abotvinik/Pololu-Lane-Keeping/TestImages/test_mergeR.jpg

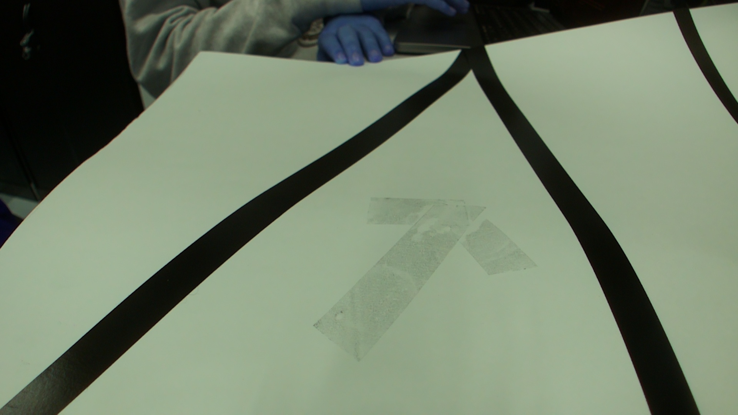
TestImages/test_mergeR.jpg
