abotvinik/Pololu-Lane-Keeping/TestImages/test_right.jpg

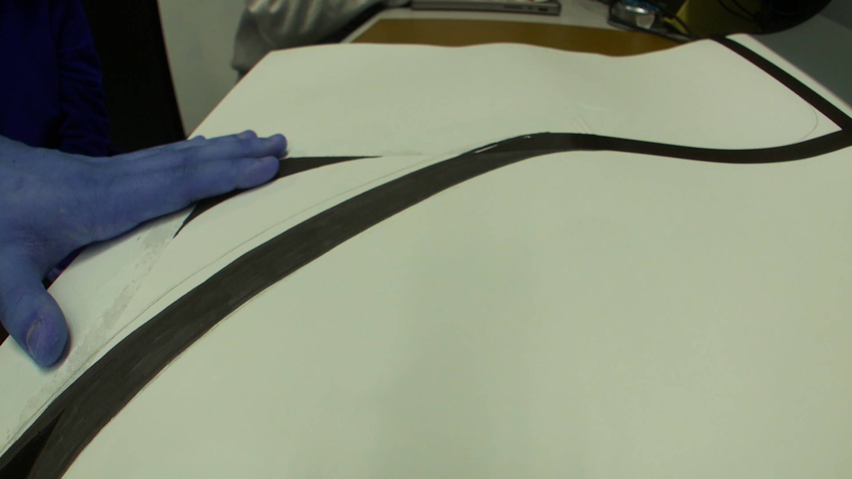
TestImages/test_right.jpg
