abotvinik/Pololu-Lane-Keeping/demo tracks.pdf

Driving Straight

Turns

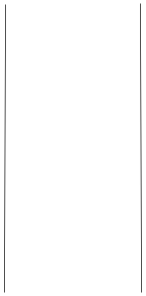
[picture p4: figure]
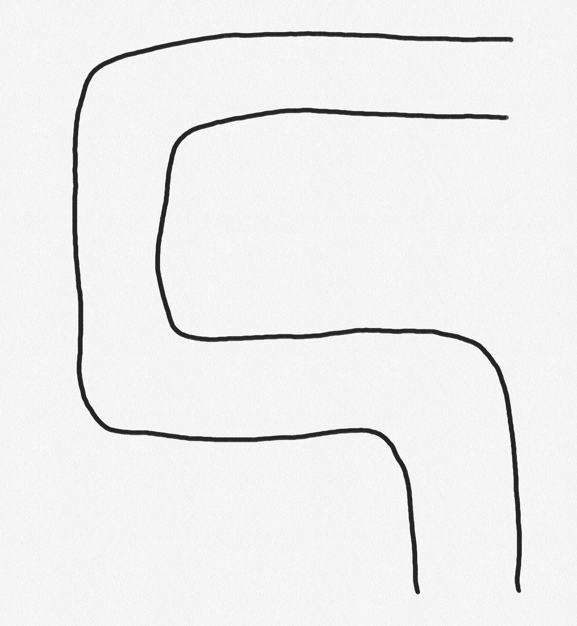
[picture p5: figure]

Merge Lanes

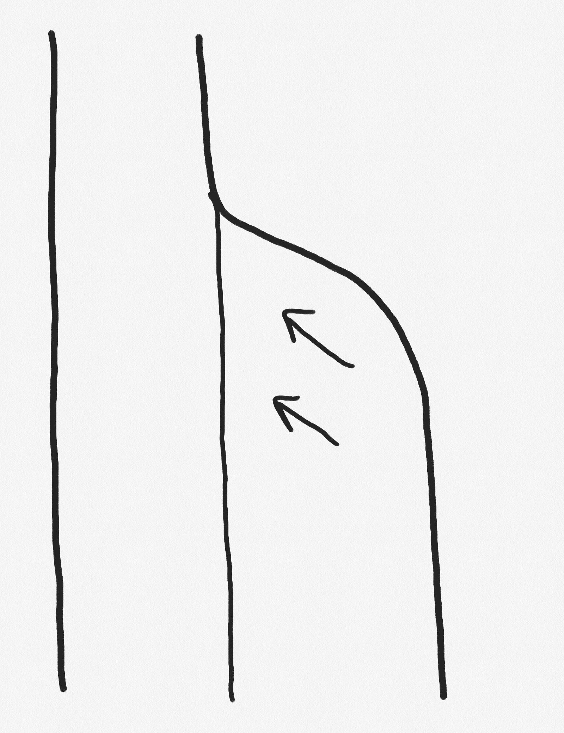
[picture p6: figure]

Final demo

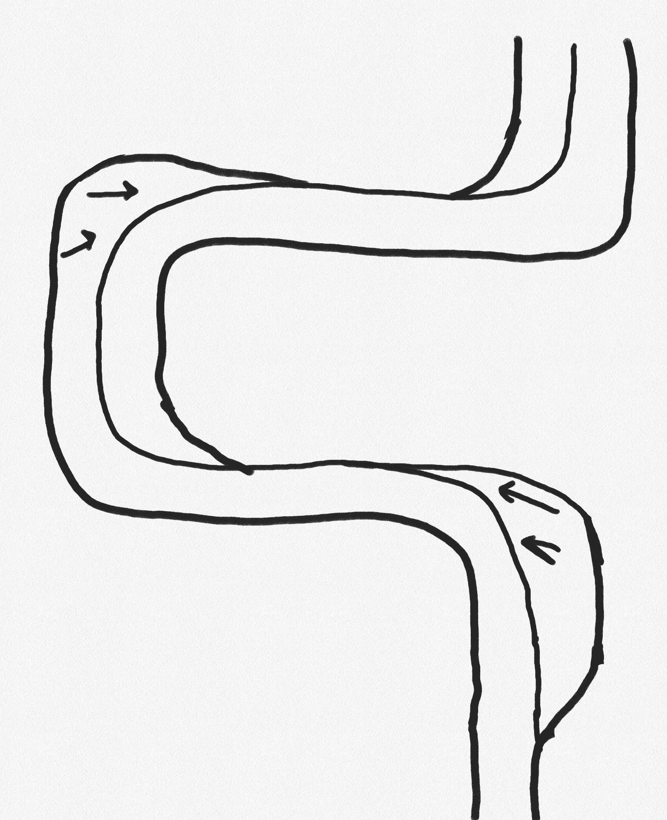
[picture p7: figure]
