abotvinik/Pololu-Lane-Keeping/CAD Models/RBPB.stl

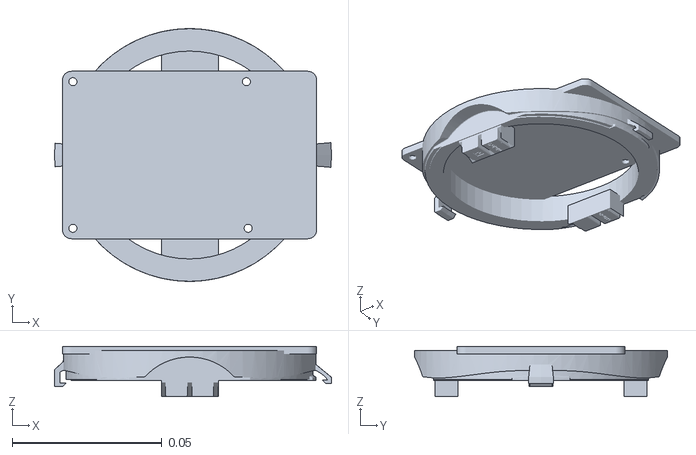
[picture p8: CAD file, 2023-11-08]
CAD Models/RBPB.stl
0.0926 x 0.0845 x 0.0167
