abotvinik/Pololu-Lane-Keeping/CADModels/RSPWITHBTTRYHLDER.stl

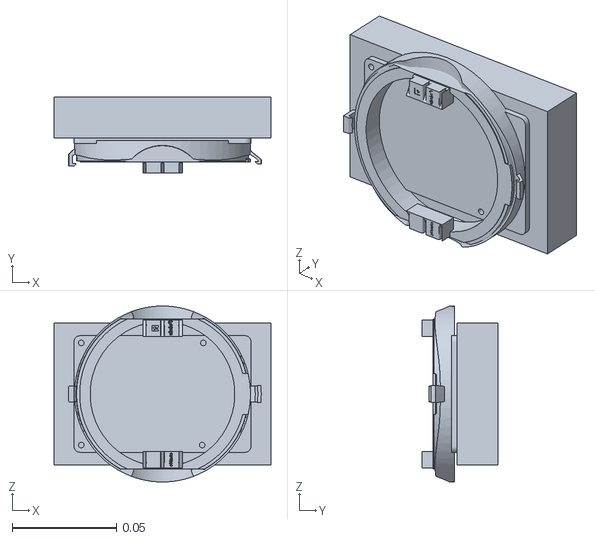
[picture p9: CAD file, 2023-12-04]
CADModels/RSPWITHBTTRYHLDER.stl
0.104 x 0.0364 x 0.0845
