abotvinik/Pololu-Lane-Keeping/TestImages/edges_left.jpg

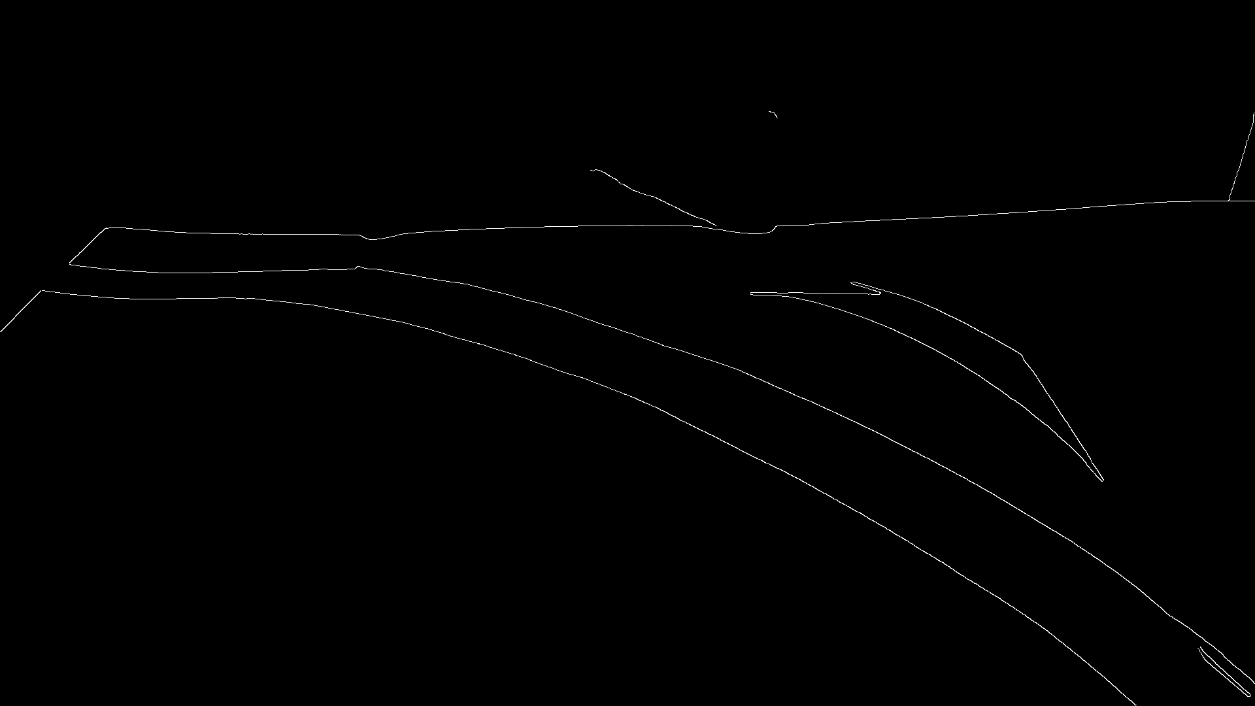
TestImages/edges_left.jpg
