abotvinik/Pololu-Lane-Keeping/TestImages/edges_mergeL.jpg

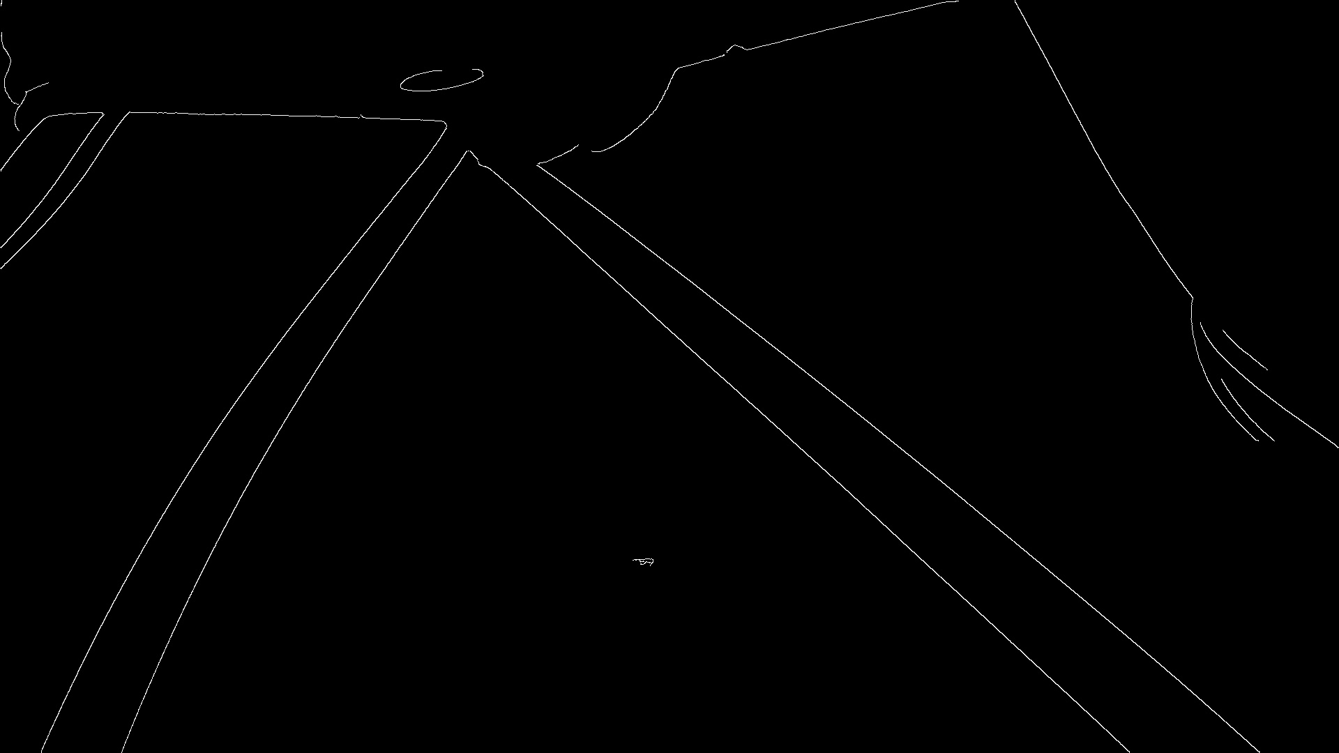
TestImages/edges_mergeL.jpg
