abotvinik/Pololu-Lane-Keeping/TestImages/edges_mergeR.jpg

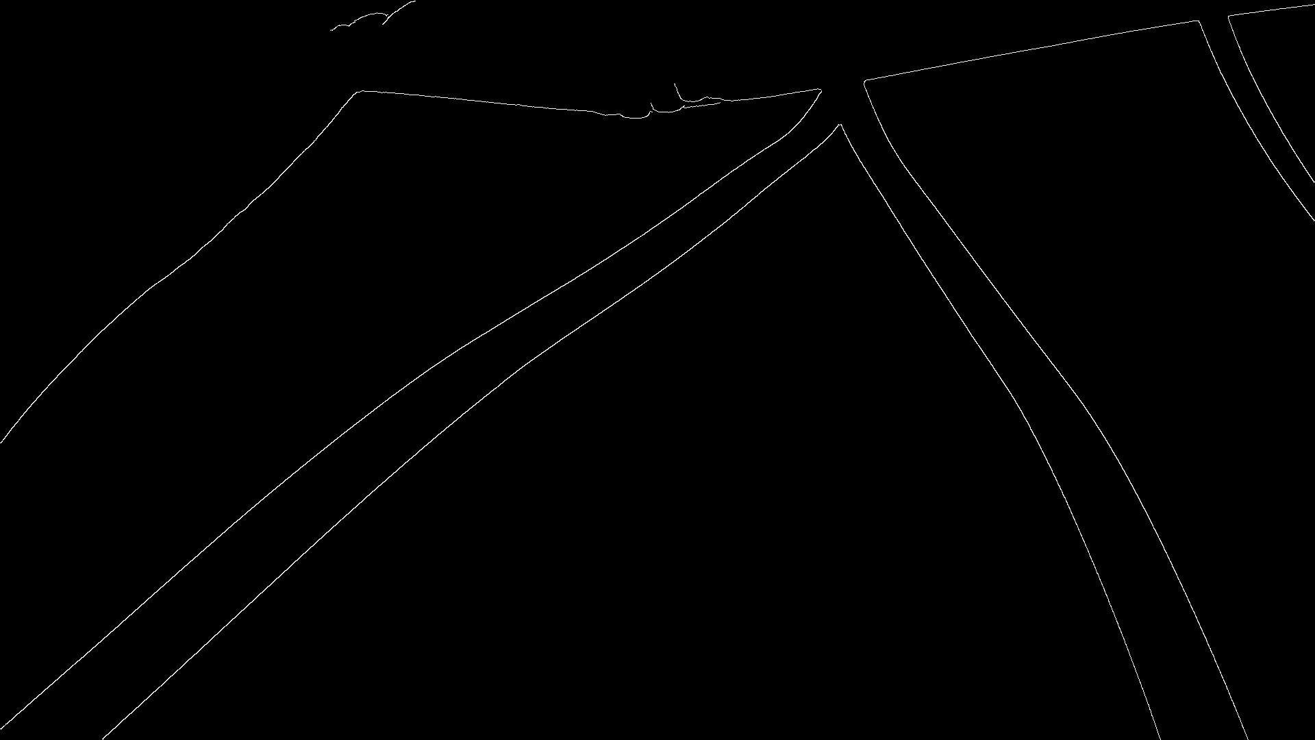
TestImages/edges_mergeR.jpg
