abotvinik/Pololu-Lane-Keeping/TestImages/edges_right.jpg

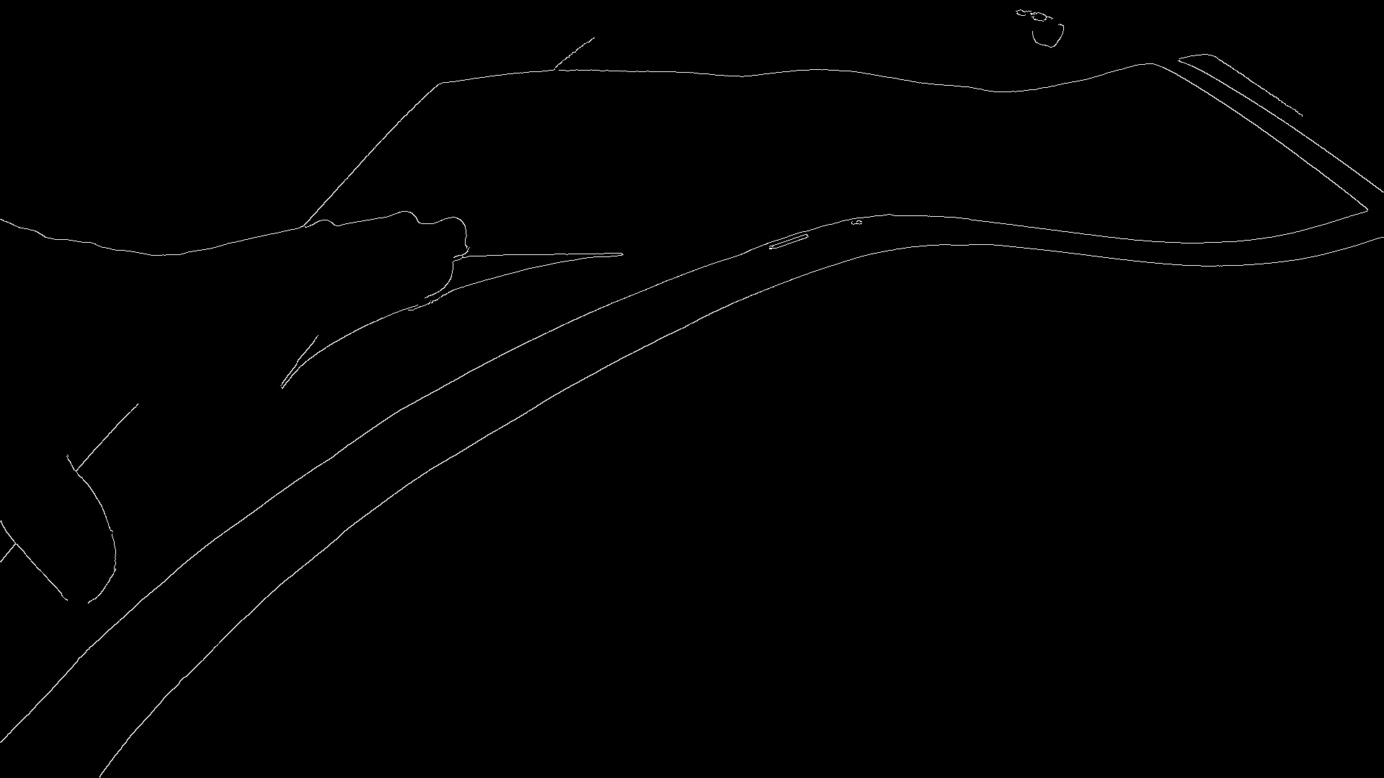
TestImages/edges_right.jpg
