abotvinik/Pololu-Lane-Keeping/TestImages/edges_straight.jpg

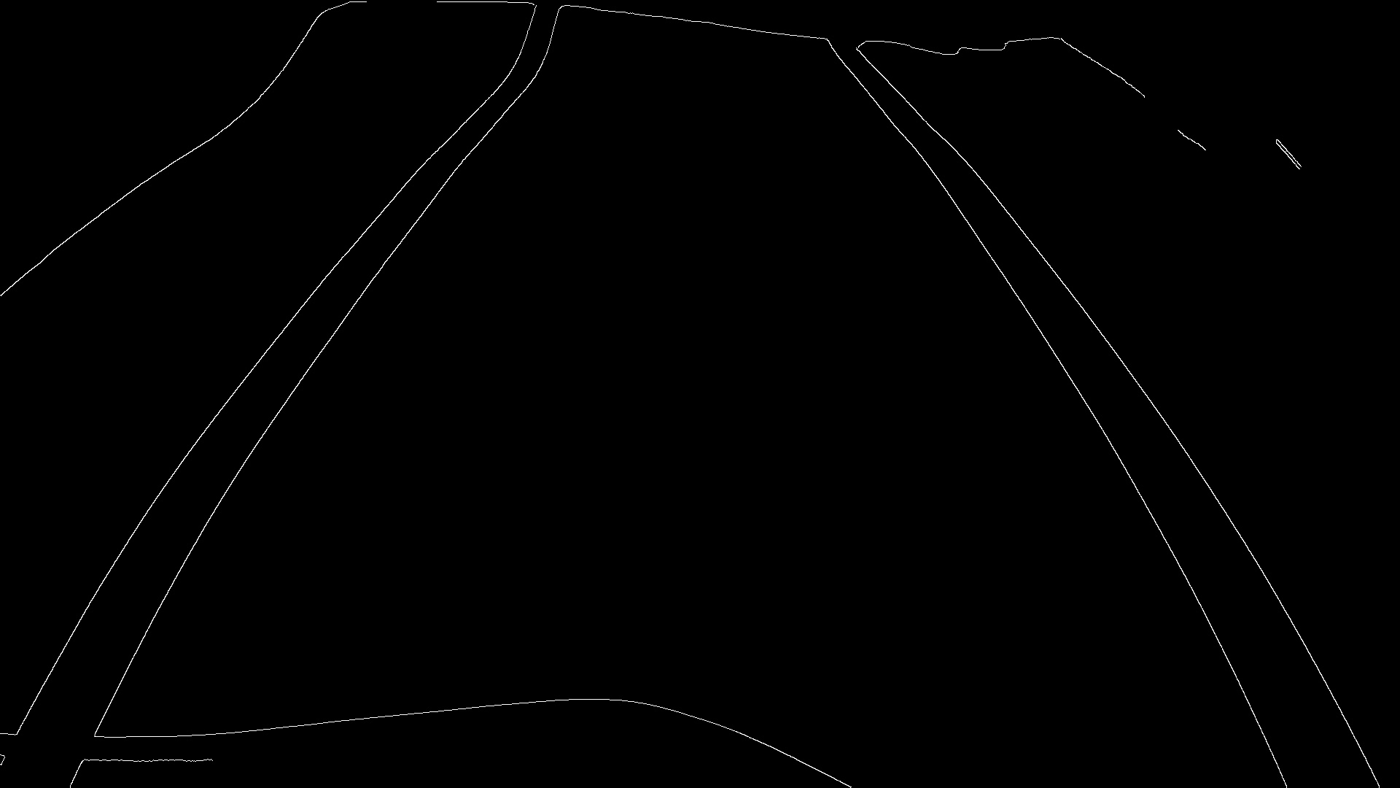
TestImages/edges_straight.jpg
