abotvinik/Pololu-Lane-Keeping/TestImages/test_left.jpg

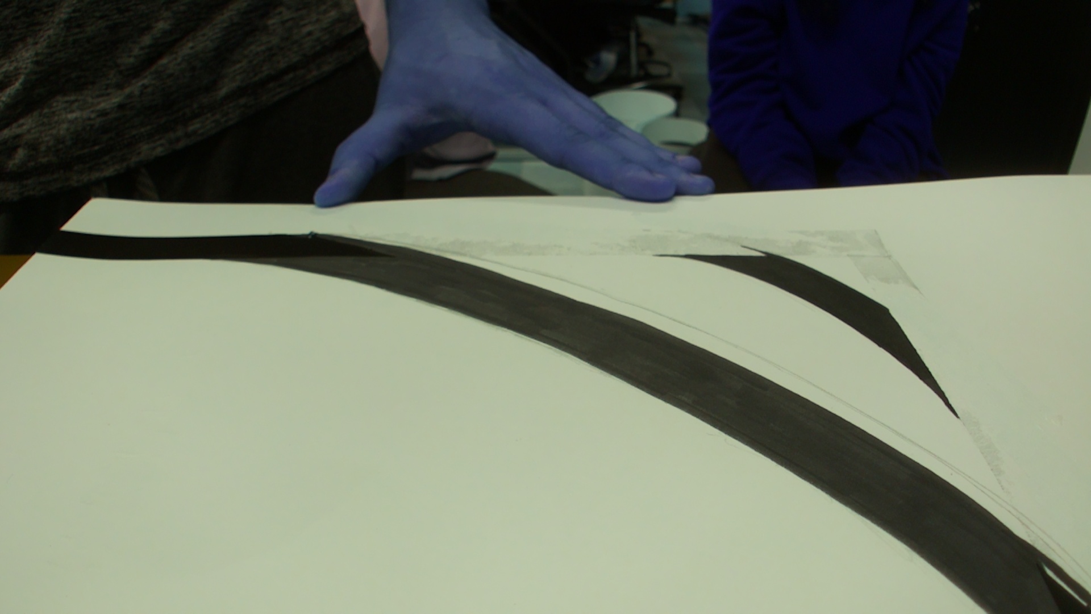
TestImages/test_left.jpg
