abotvinik/Pololu-Lane-Keeping/TestImages/test_mergeL.jpg

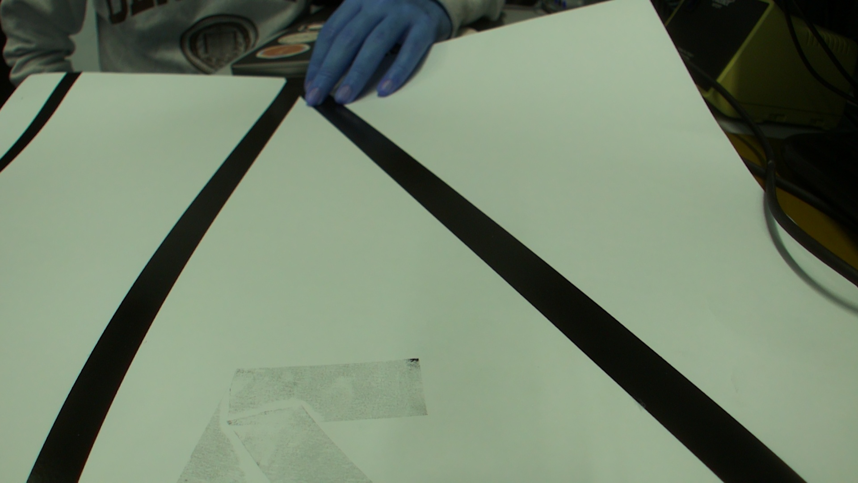
TestImages/test_mergeL.jpg
