abotvinik/Pololu-Lane-Keeping/TestImages/test_straight.jpg

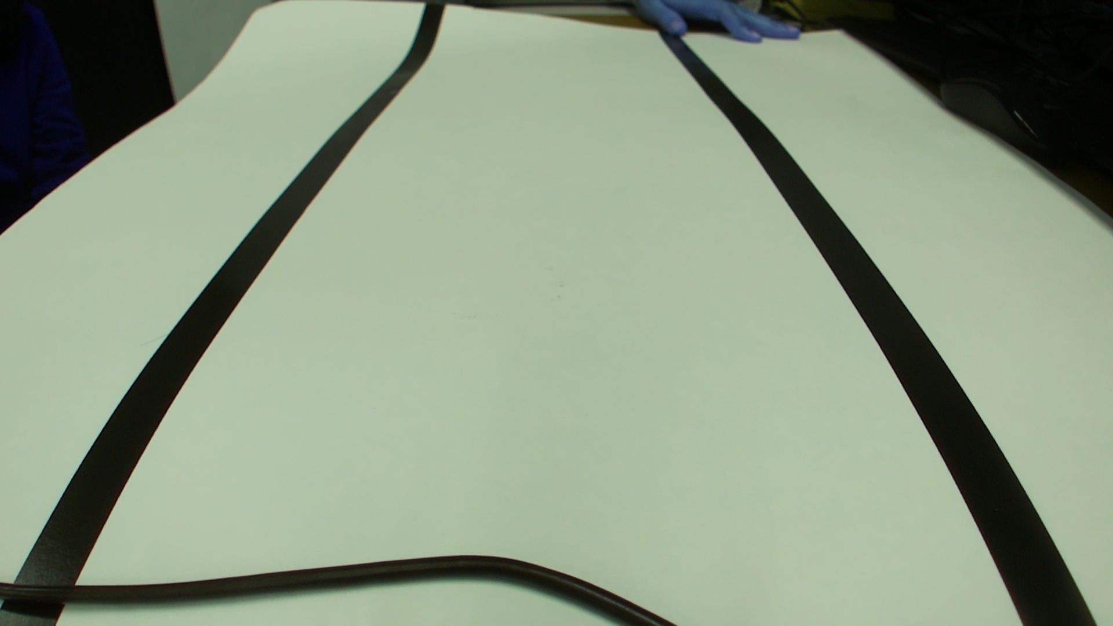
TestImages/test_straight.jpg
