abotvinik/Pololu-Lane-Keeping/(commit log)

2023-11-08 added base cad files
    [RBPB.stl]
2023-11-08 adding track designs
2023-11-09 Prototype Basic CV Lane Detect Code
2023-12-04 uart push and recieve
2023-12-04 new 3d printed case with battery holder
    [RSPWITHBTTRYHLDER.stl]
2023-12-05 Testing UART Setup on Pi
2023-12-11 Cap Turn Power, Merge Testing
2023-12-11 Replace Canny Edge Detection with Binary Filter
    [LaneDetect.py]
